Ganghyeok/BLDC_Motor_Controller_24V/Document/참고 문서/pantarhei BLDC 회로도.png

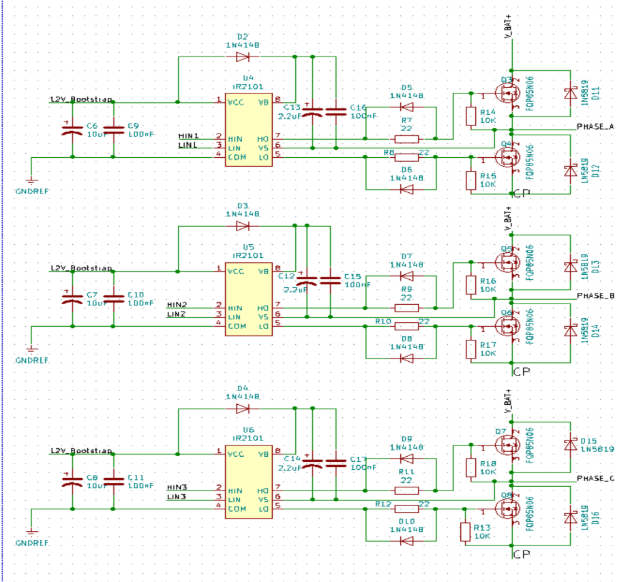
Document/참고 문서/pantarhei BLDC 회로도.png
