Ganghyeok/BLDC_Motor_Controller_24V/Sch/BLDC_Motor_Controller_Ver1.0A(기본 버전).pdf

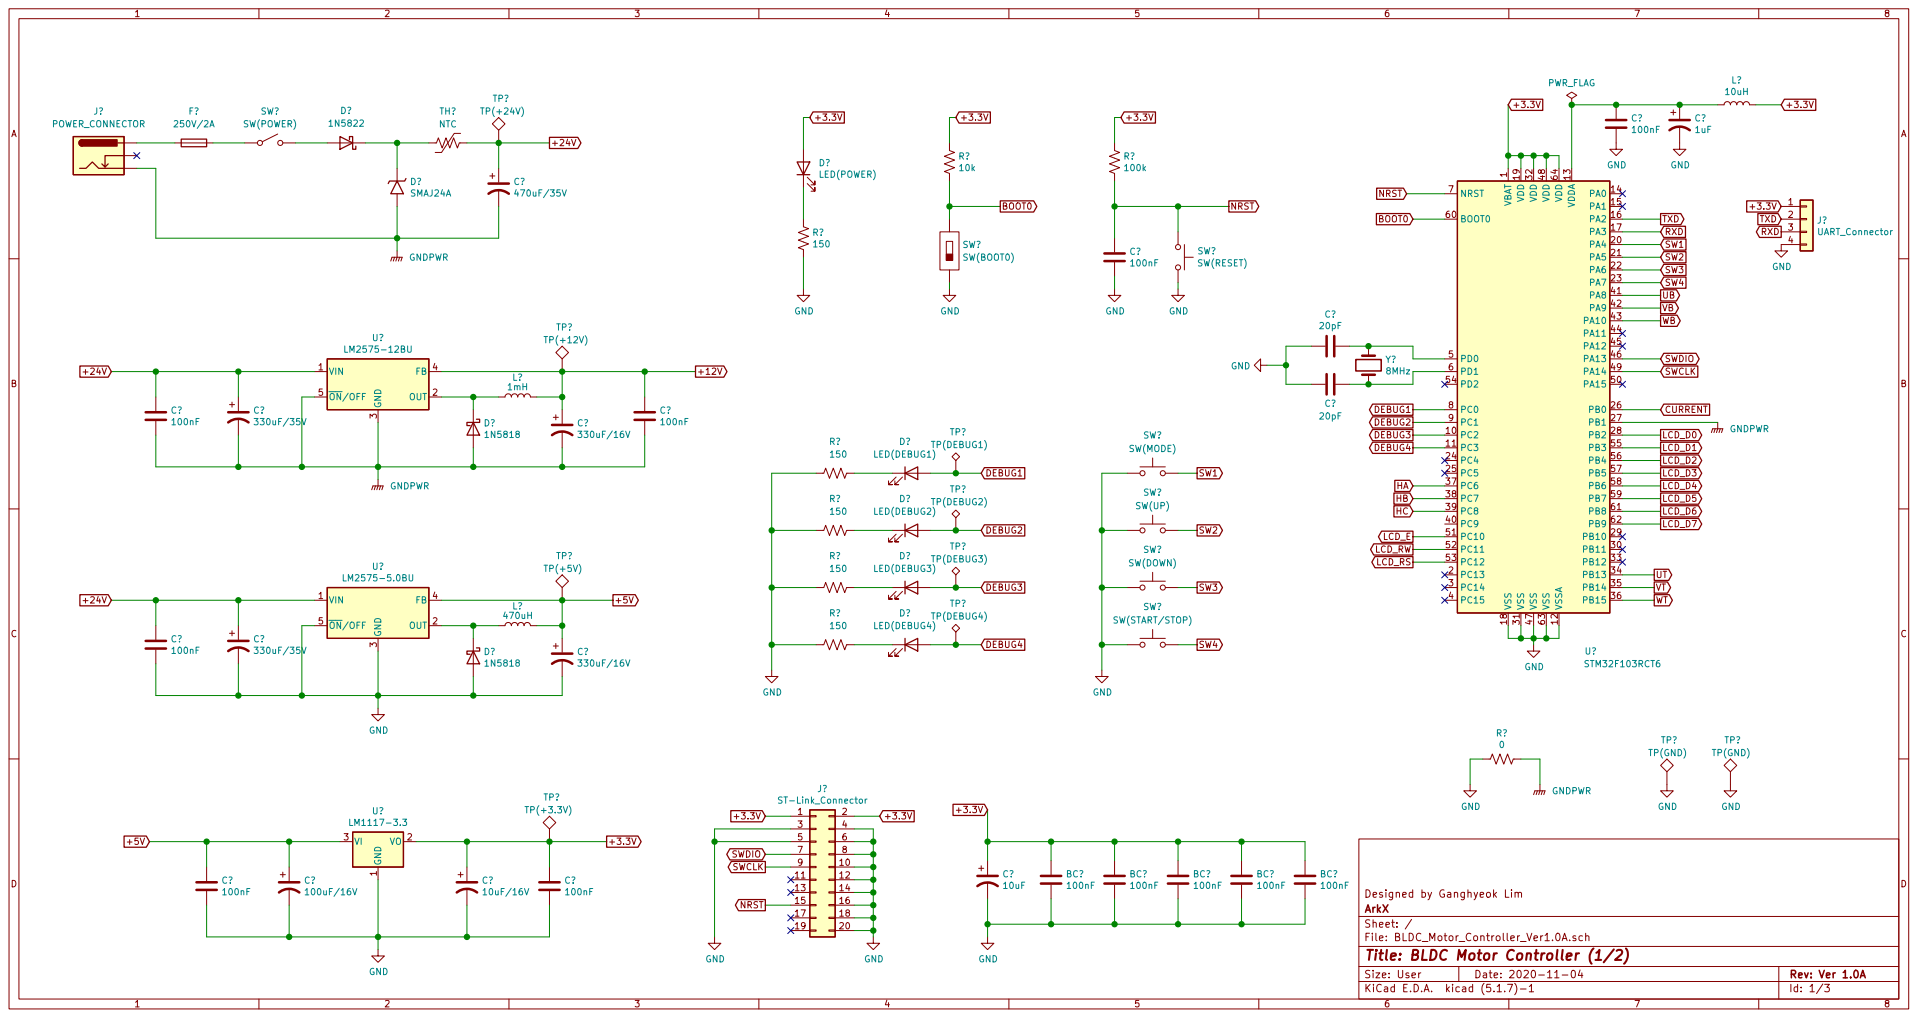
[picture p3: page 1]

TP? TP(DEBUG1) TH? NTC

1 VDD 19 VDD 32 VDD 48 VDD 64 VDDA 13 VSS 18 VSS 31 VSS 47 VSS 63 VSSA 12 U?STM32F103RCT6

SW? SW(START/STOP) GNDPWR

SW? SW(UP) SW? SW(MODE) C?

TP? TP(GND) TP? TP(GND) GNDPWR GND
SW? SW(DOWN) TP? TP(DEBUG2) GND

100nF BC? | File: BLDC_Motor_Controller_Ver1.0A.sch Sheet: / ArkX Designed by Ganghyeok Lim

Id: 1/3 Title: BLDC Motor Controller (1/2)

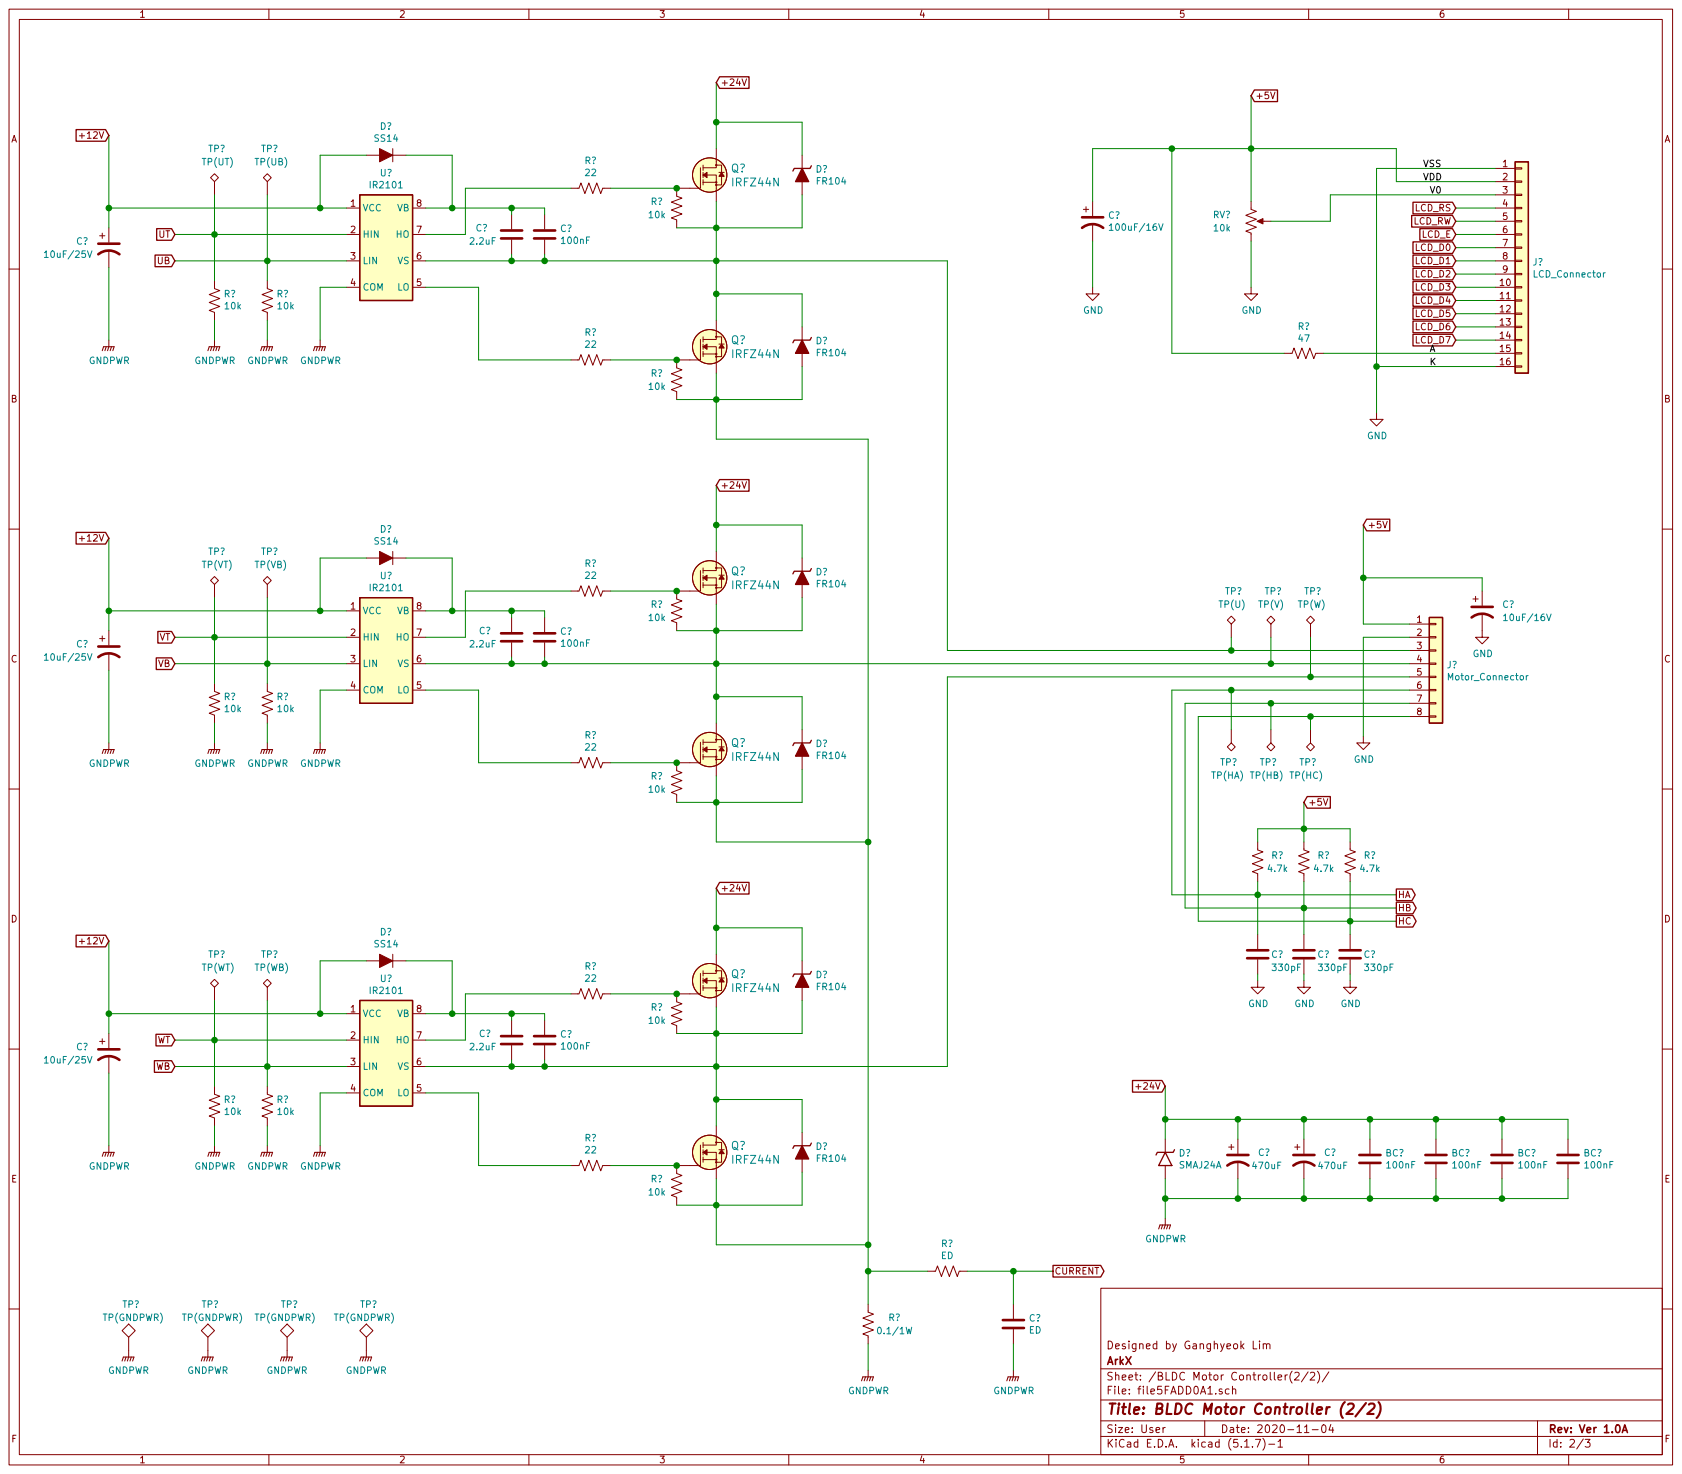
[picture p4: page 2]

Id: 2/3 Title: BLDC Motor Controller (2/2) File: file5FADD0A1.sch Sheet: /BLDC Motor Controller(2/2)/ ArkX Designed by Ganghyeok Lim

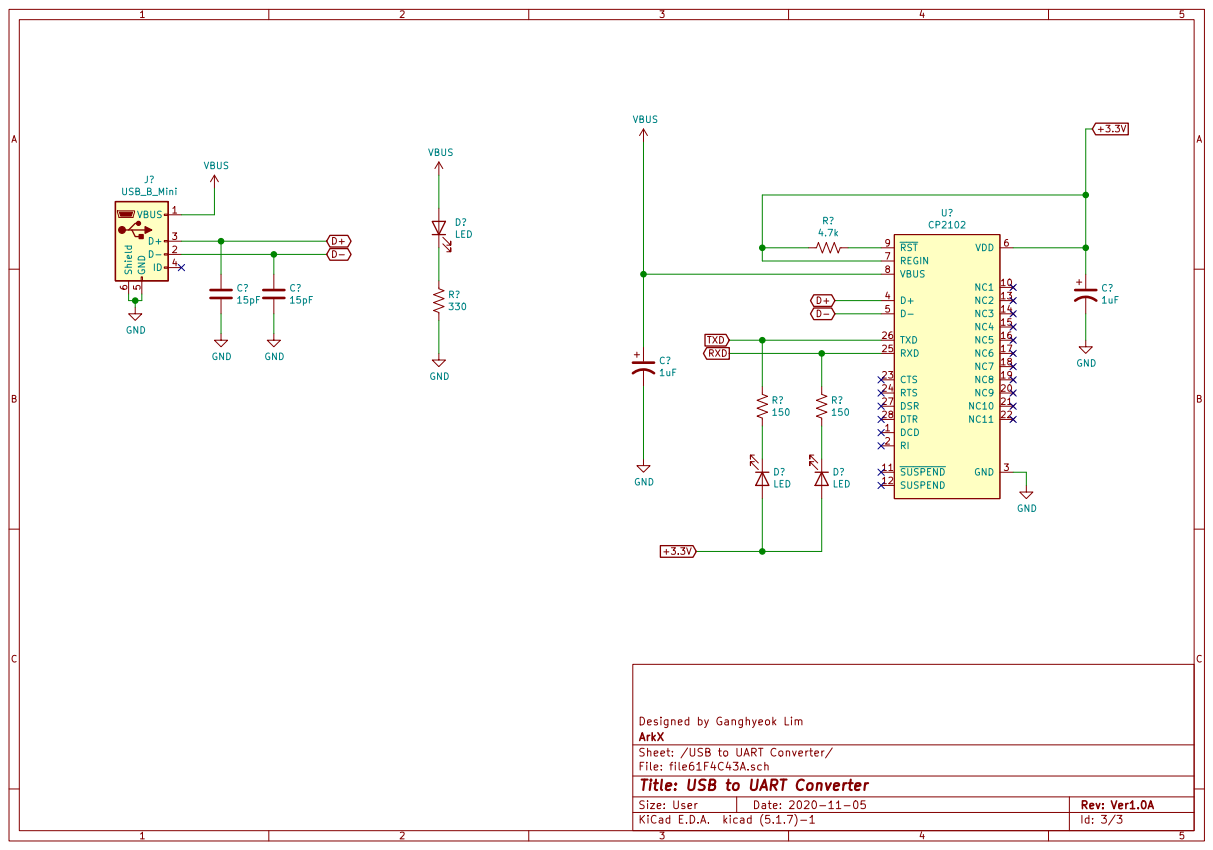
[picture p5: page 3]

Id: 3/3 Title: USB to UART Converter File: file61F4C43A.sch Sheet: /USB to UART Converter/ ArkX Designed by Ganghyeok Lim
