Ganghyeok/BLDC_Motor_Controller_24V/PCB/BLDC_Motor_Controller_Ver2.0A/BLDC_Motor_Controller_Ver2.0A.pdf

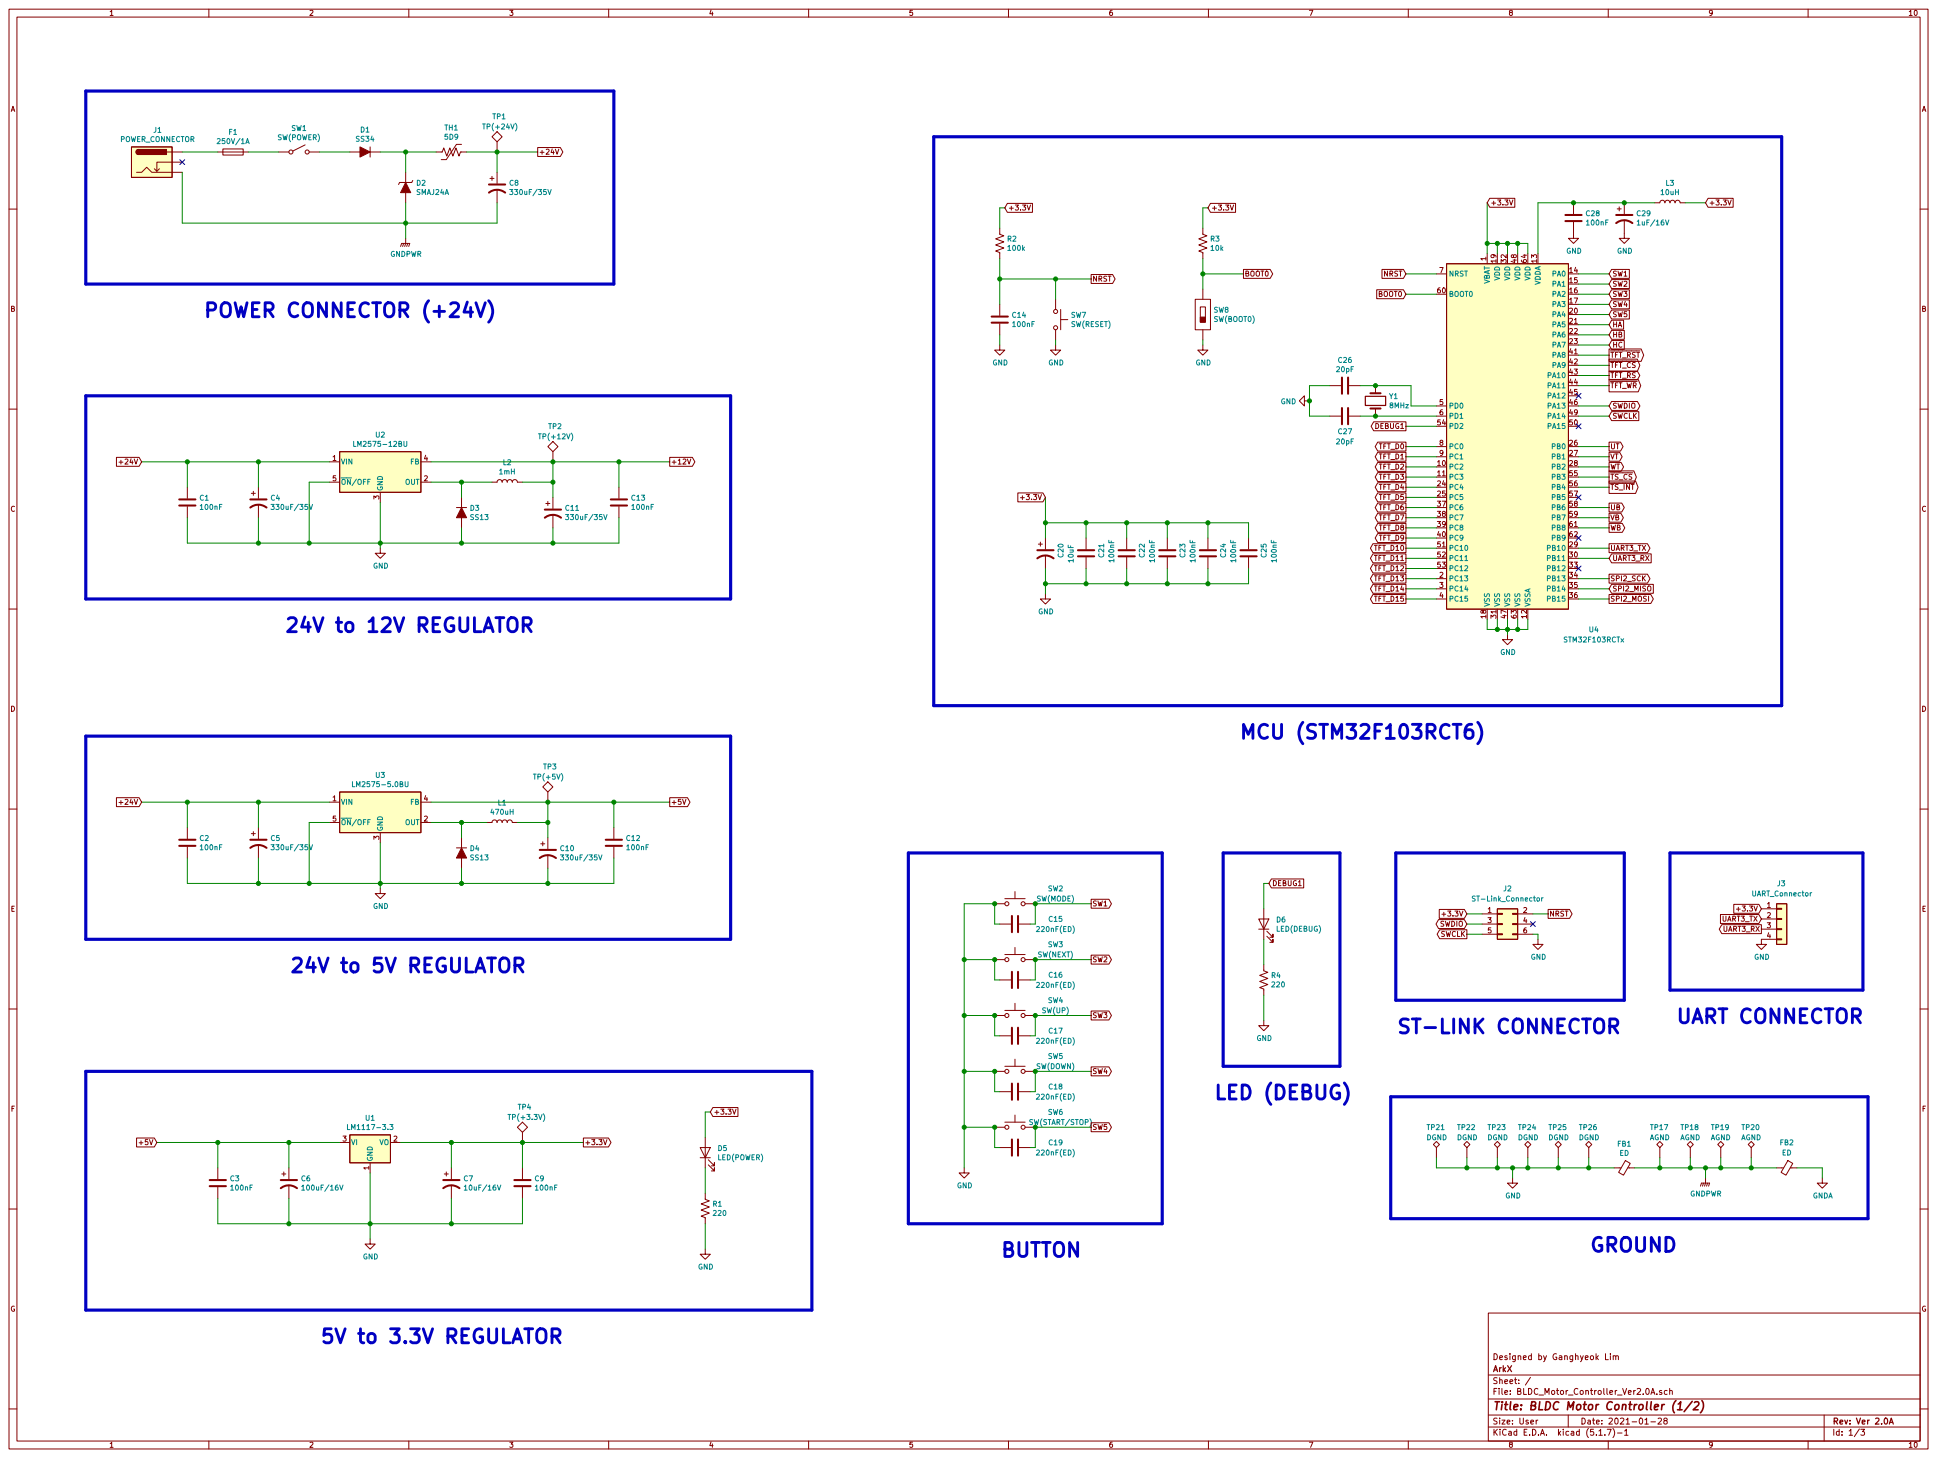
[picture p6: page 1]

1 VDD 19 VDD 32 VDD 48 VDD 64 VDDA 13 VSS 18 VSS 31 VSS 47 VSS 63 VSSA 12 U4 STM32F103RCTx Y1
HBHA NRST

220nF(ED) SW6 SW(START/STOP) C19

File: BLDC_Motor_Controller_Ver2.0A.sch Sheet: / ArkX Designed by Ganghyeok Lim

Id: 1/3 Title: BLDC Motor Controller (1/2)

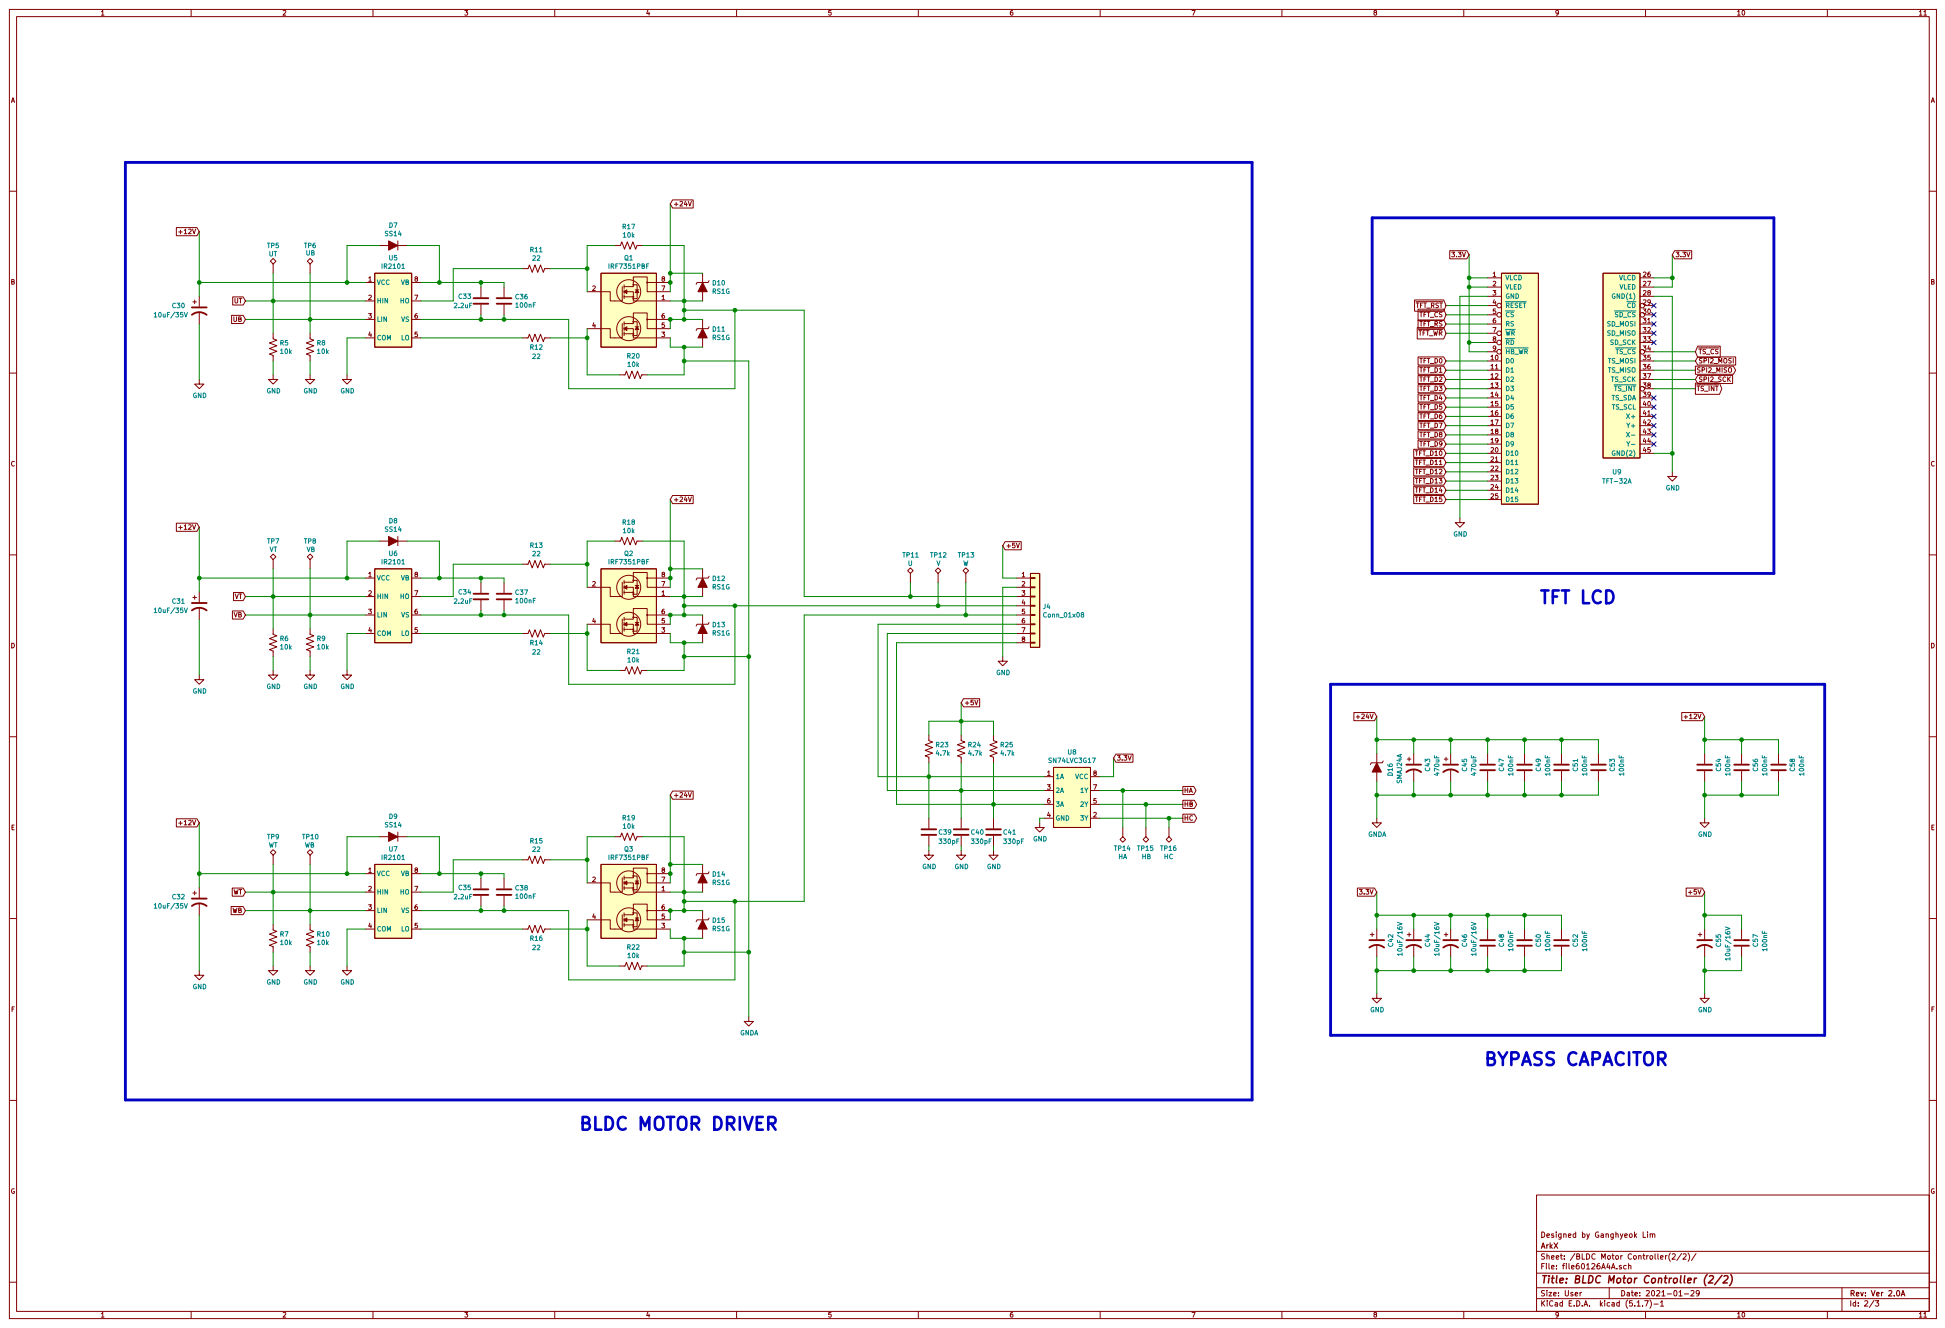
[picture p7: page 2]

Id: 2/3 Title: BLDC Motor Controller (2/2) File: file60126A4A.sch Sheet: /BLDC Motor Controller(2/2)/ ArkX Designed by Ganghyeok Lim

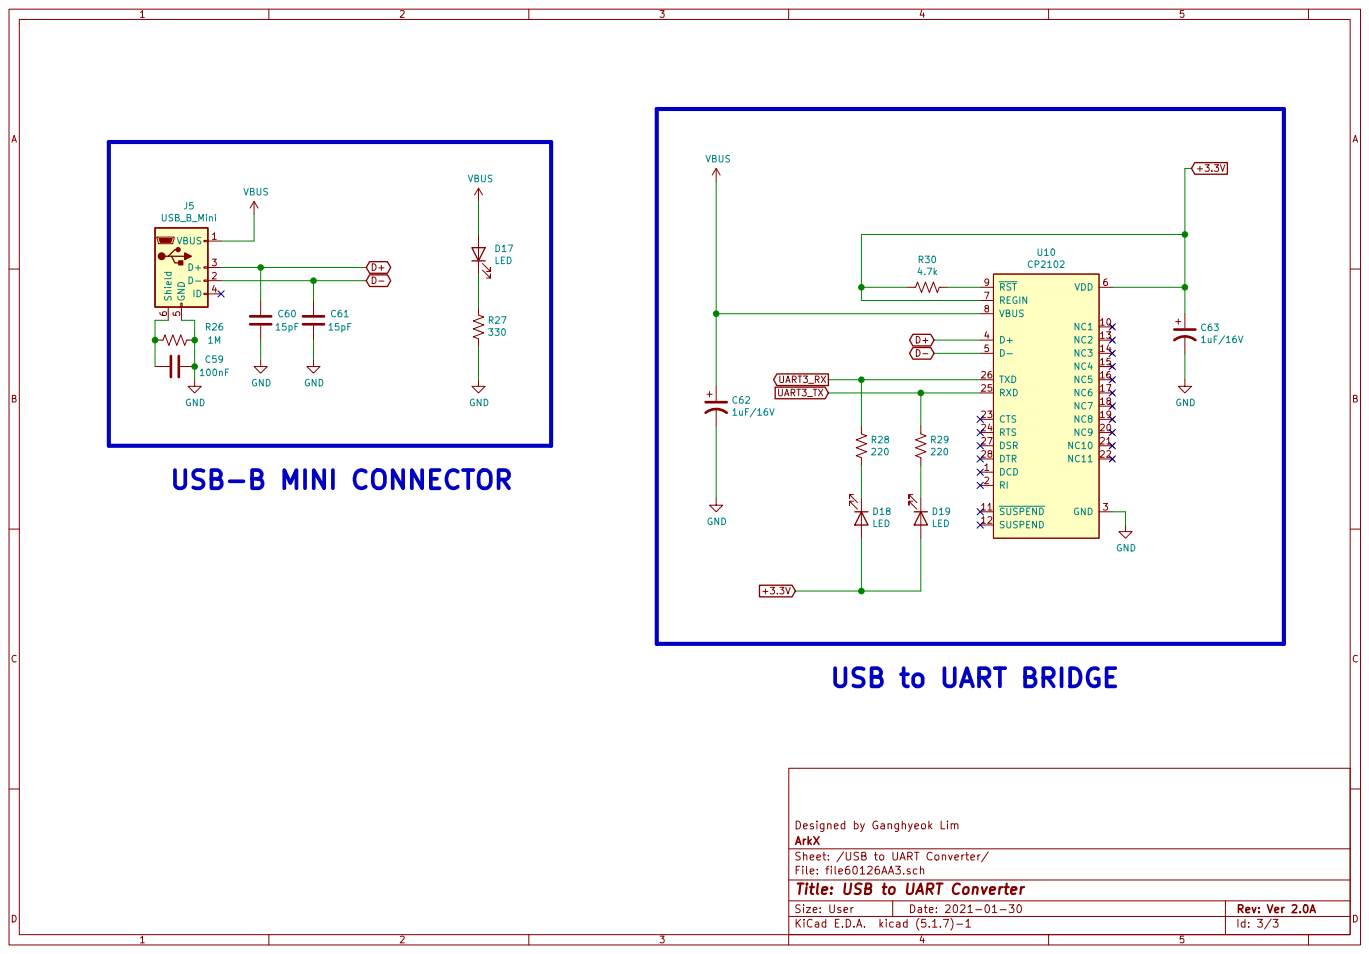
[picture p8: page 3]

Id: 3/3 Title: USB to UART Converter File: file60126AA3.sch Sheet: /USB to UART Converter/ ArkX Designed by Ganghyeok Lim
