Ganghyeok/BLDC_Motor_Controller_24V/Document/참고 문서/STM32F407 커스텀 보드 회로도.pdf

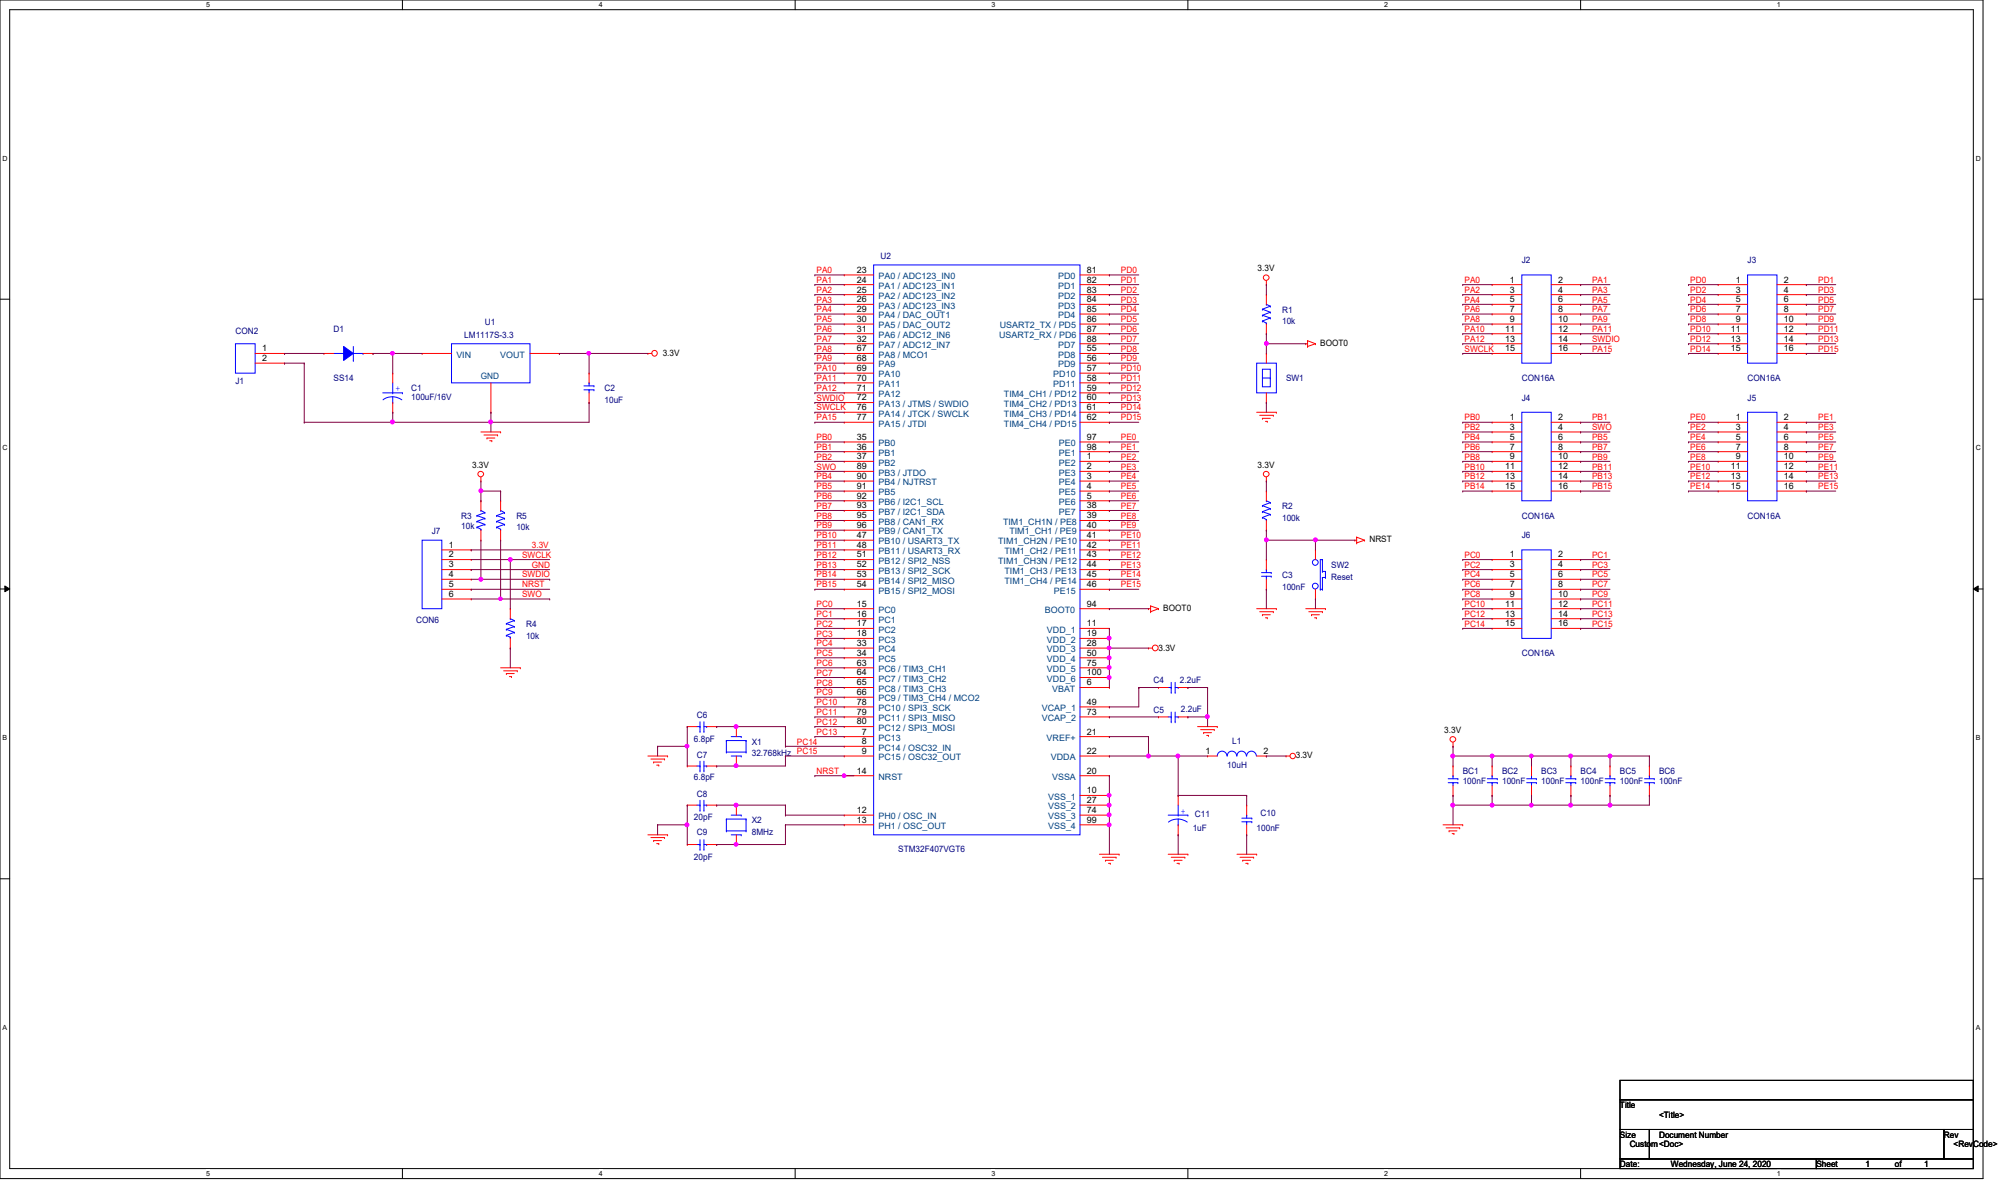
[picture p9: page 1]
