Ganghyeok/BLDC_Motor_Controller_24V/Document/참고 문서/BLDC_Motor_Controller_12V_회로도(Old Ver).pdf

DC
12V

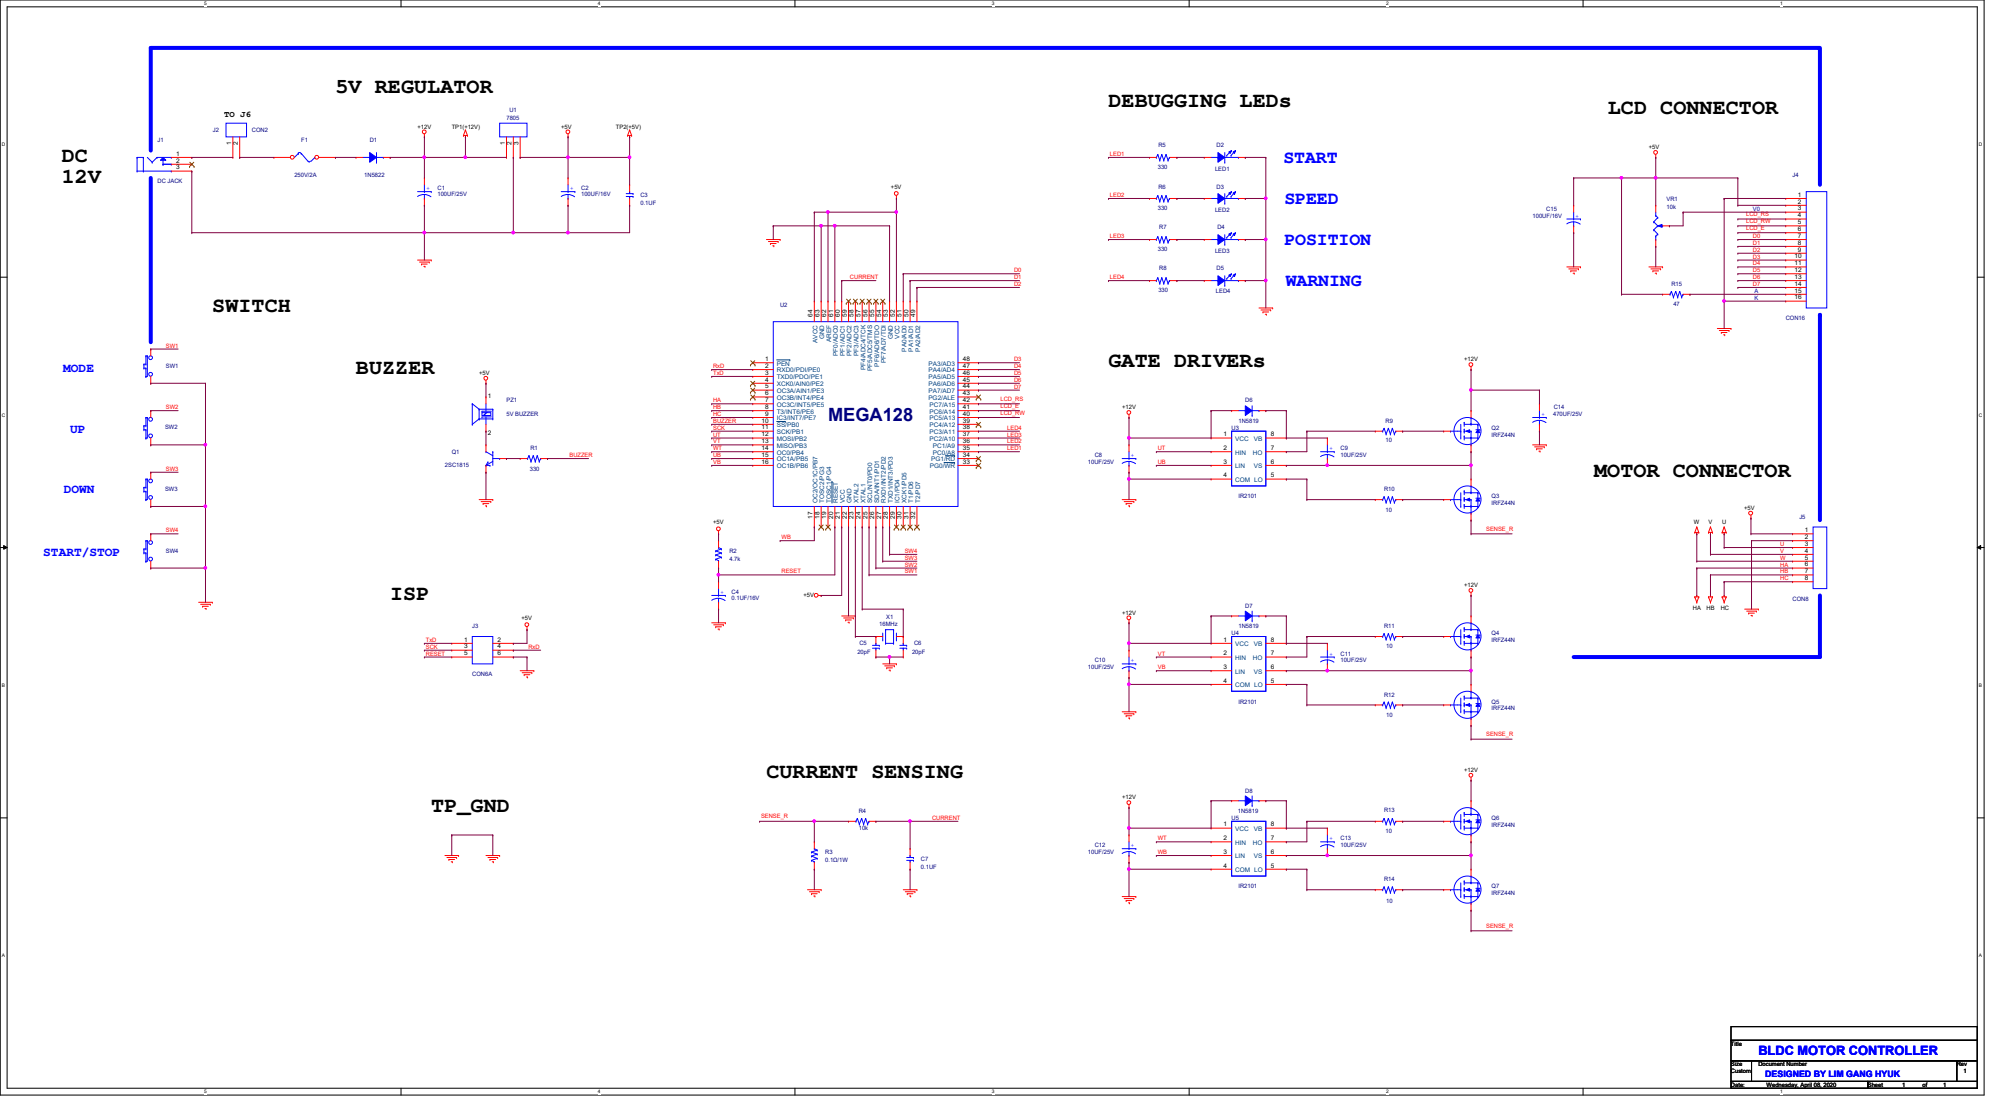
[picture p10: page 1]
