Ganghyeok/BLDC_Motor_Controller_24V/PCB/BLDC_Motor_Controller_Ver2.0A/BLDC_Motor_Controller_Ver2.0A.kicad_pcb

## KiCad design PCB/BLDC_Motor_Controller_Ver2.0A/BLDC_Motor_Controller_Ver2.0A.kicad_pcb (2021-02-27)

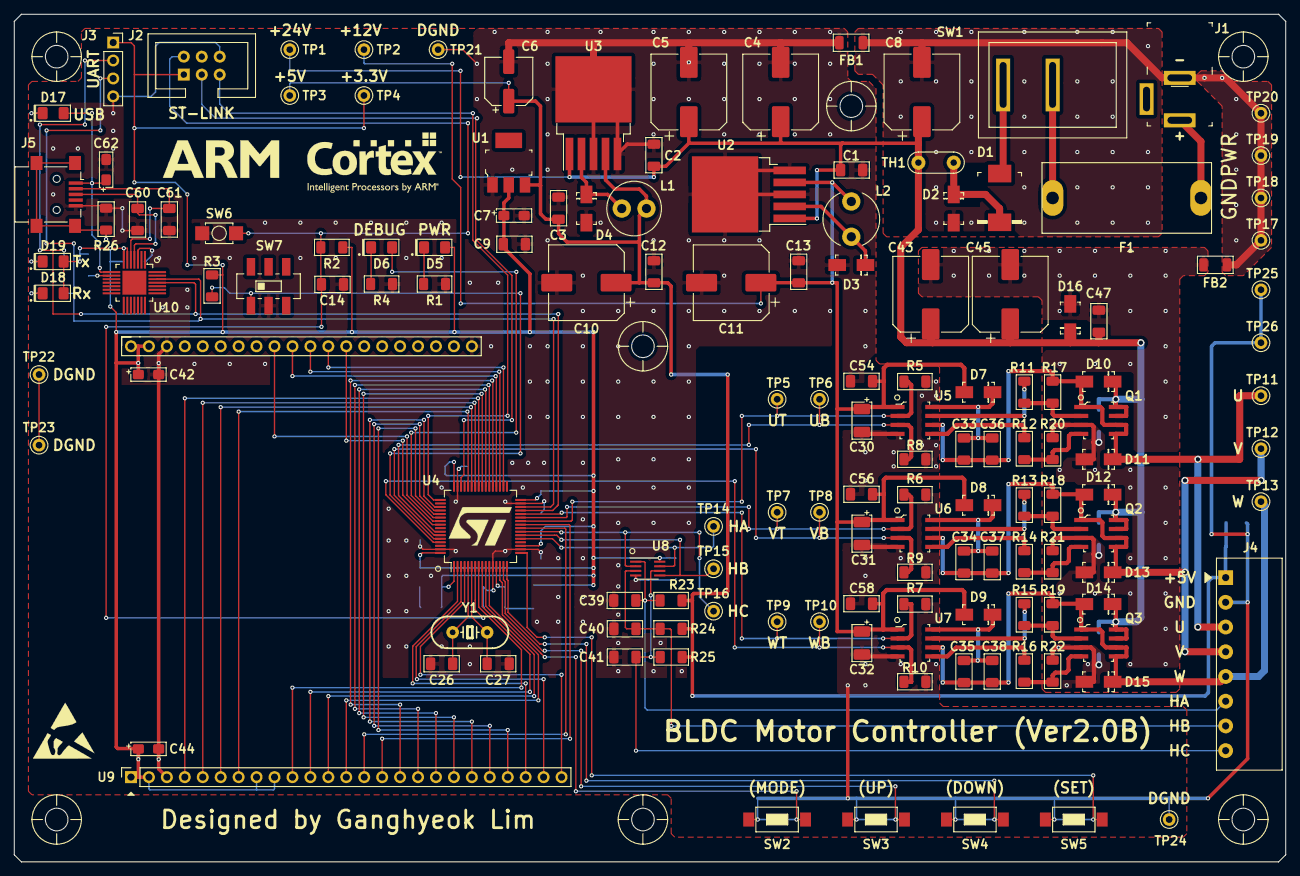
[picture p11: board BLDC_Motor_Controller_Ver2.0A.kicad_pcb from above]

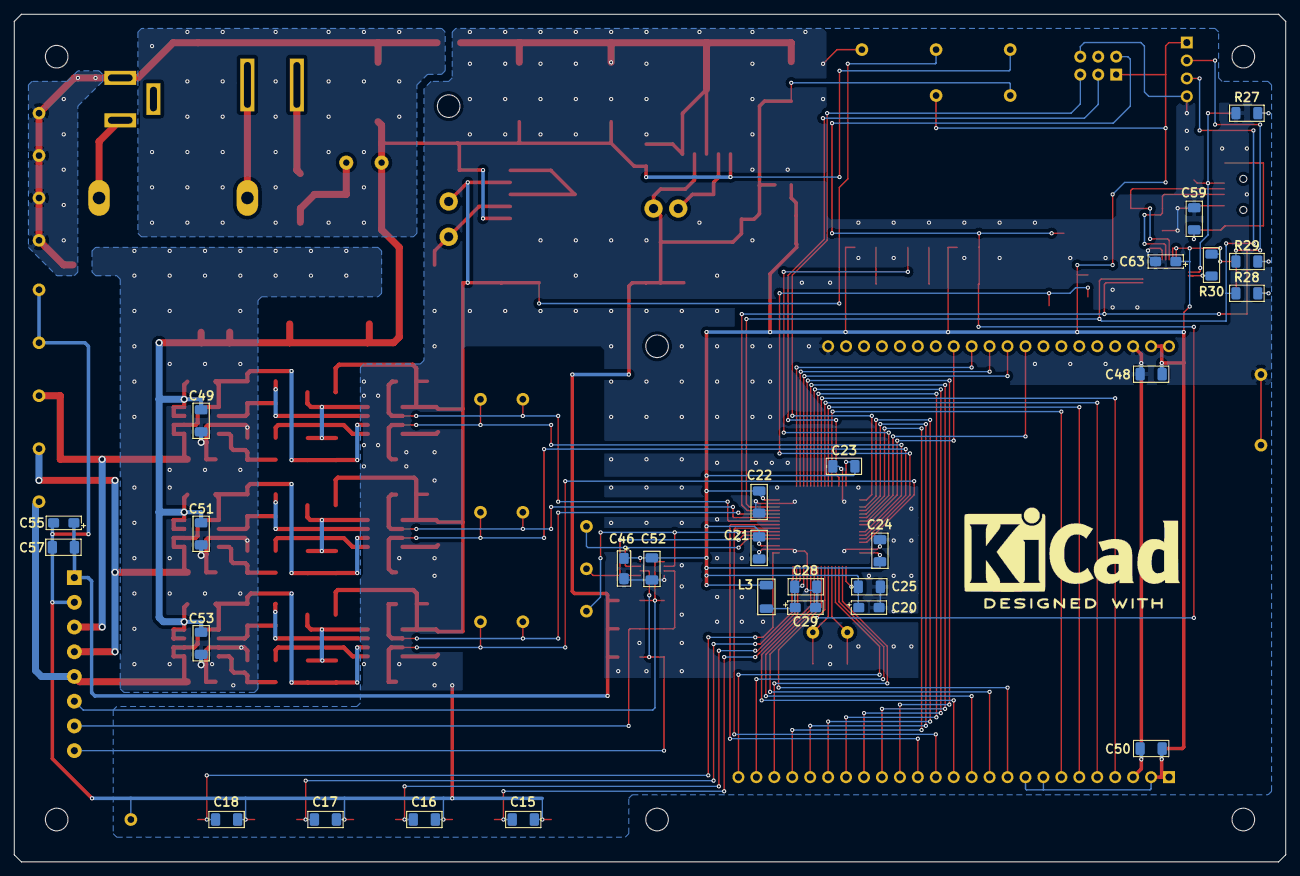
[picture p12: board BLDC_Motor_Controller_Ver2.0A.kicad_pcb from below]

Board: 2 copper layers, 180.0 x 120.0 mm, 170 parts (28 on the bottom side), 92 nets.

Parts:
C1, C2, C3, C9, C12, C13, C14, C21, C22, C23, C24, C25, C28, C36, C37, C38, C47, C48, C49, C50, C51, C52, C53, C54, C56, C57, C58, C59: 100nF; C3216_Metric
C4, C5, C8, C10, C11: 330uF/35V; CP_Elec_10x10.5
C6: 100uF/16V; CP_Elec_6.3x5.3
C7, C20, C42, C44, C46, C55: 10uF/16V; C3216_Tantal_Metric
C15, C16, C17, C18: 220nF(ED); C3216_Metric
C26, C27: 20pF; C3216_Metric
C29, C62, C63: 1uF/16V; C3216_Tantal_Metric
C30, C31, C32: 10uF/25V; C3528_Tantal_Metric
C33, C34, C35: 2.2uF; C3216_Metric
C39, C40, C41: 330pF; C3216_Metric
C43, C45: 470uF/35V; CP_Elec_10x10.5
C60, C61: 15pF; C3216_Metric
D1: SS34; DO-214AB
D2, D16: SMAJ24A; DO-214AC
D3, D4: SS13; DO-214AC
D5: LED(POWER); LED_3216_Metric
D6: LED(DEBUG); LED_3216_Metric
D7, D8, D9: SS14; DO-214AC
D10, D11, D12, D13, D14, D15: RS1G; DO-214AC
D17, D18, D19: LED; LED_3216_Metric
F1: 250V/1A; GF-205B(20mm)
FB1, FB2: ED; L3216_Metric
J1: POWER_CONNECTOR; Barrel_Jack_5.5mmODx2.1mmID_PJ-202A
J2: ST-Link_Connector; BHS-01-6P
J3: UART_Connector; PinSocket_1x04_P2.54mm_Vertical
J4: Conn_01x08; Terminal_Block_3.5mm_8P
J5: USB_B_Mini; USB_Mini-B_Lumberg_2486_01_Horizontal
L1: 470uH; L_Radial_D7.5mm_P3.50mm_Fastron_07P
L2: 1mH; L_Radial_D7.8mm_P5.00mm_Fastron_07HCP
L3: 10uH; L3216_Metric
Q1, Q2, Q3: IRF7351PBF; SOIC-8_W3.9mm
R1, R4, R28, R29: 220; R3216_Metric
R2: 100k; R3216_Metric
R3, R5, R6, R7, R8, R9, R10, R17, R18, R19, R20, R21, R22: 10k; R3216_Metric
R11, R12, R13, R14, R15, R16: 22; R3216_Metric
R23, R24, R25, R30: 4.7k; R3216_Metric
R26: 1M; R3216_Metric
R27: 330; R3216_Metric
SW1: SW(POWER); KCD1-101A
SW2: SW(MODE); ITS-1107(SMD)
SW3: SW(UP); ITS-1107(SMD)
SW4: SW(DOWN); ITS-1107(SMD)
SW5: SW(START/STOP); ITS-1107(SMD)
SW6: SW(RESET); SW_TACT_SMD_W3.9mm_L2.9mm_H2mm_GH
SW7: SW(BOOT0); SW_Slide_6P_SMD_GH
TH1: 5D9; NTC-5D-7_9
TP1: TP(+24V); Test_Point(Loop)
TP2: TP(+12V); Test_Point(Loop)
TP3: TP(+5V); Test_Point(Loop)
TP4: TP(+3.3V); Test_Point(Loop)
TP5: UT; Test_Point(Loop)
TP6: UB; Test_Point(Loop)
TP7: VT; Test_Point(Loop)
TP8: VB; Test_Point(Loop)
TP9: WT; Test_Point(Loop)
TP10: WB; Test_Point(Loop)
TP11: U; Test_Point(Loop)
TP12: V; Test_Point(Loop)
TP13: W; Test_Point(Loop)
TP14: HA; Test_Point(Loop)
TP15: HB; Test_Point(Loop)
TP16: HC; Test_Point(Loop)
TP17, TP18, TP19, TP20: AGND; Test_Point(Loop)
TP21, TP22, TP23, TP24, TP25, TP26: DGND; Test_Point(Loop)
U1: LM1117-3.3; SOT-223
U2: LM2575-12BU; TO-263-5_TabPin3
U3: LM2575-5.0BU; TO-263-5_TabPin3
U4: STM32F103RCTx; LQFP-64_10x10mm_P0.5mm
U5, U6, U7: IR2101; SOIC-8_W3.9mm
U8: SN74LVC3G17; SSOP-8_2.95x2.8mm_P0.65mm
U9: TFT-32A
U10: CP2102; VFQFN-28-1EP_5x5mm_HandSolder
Y1: 8MHz; CRYSTAL_HC49_PTH

Connections:
+3.3V: C7.1, C9.1, C20.1, C21.1, C22.1, C23.1, C24.1, C25.1, C42.1, C44.1, C46.1, C48.1, C50.1, C52.1, C63.1, D5.2, D18.2, D19.2, J2.1, J3.1, L3.2, R2.1, R3.1, R30.1, TP4.1, U1.2, U4.1, U4.19, U4.32, U4.48, U4.64, U8.8, U9.1, U9.2, U9.8, U9.9, U9.26, U9.27, U10.6, U10.7
+5V: C3.1, C6.1, C10.1, C12.1, C55.1, C57.1, J4.1, L1.2, R23.1, R24.1, R25.1, TP3.1, U1.3, U3.4
+12V: C11.1, C13.1, C30.1, C31.1, C32.1, C54.1, C56.1, C58.1, D7.A, D8.A, D9.A, L2.2, TP2.1, U2.4, U5.1, U6.1, U7.1
+24V: C1.1, C2.1, C4.1, C5.1, C8.1, C43.1, C45.1, C47.1, C49.1, C51.1, C53.1, D10.K, D12.K, D14.K, D16.K, Q1.7, Q1.8, Q2.7, Q2.8, Q3.7, Q3.8, TH1.1, TP1.1, U2.1, U3.1
BOOT0: R3.2, SW7.1, U4.60
D+: C60.1, J5.3, U10.4
D-: C61.1, J5.2, U10.5
DEBUG1: D6.2, U4.54
GND: C1.2, C2.2, C3.2, C4.2, C5.2, C6.2, C7.2, C9.2, C10.2, C11.2, C12.2, C13.2, C14.2, C15.2, C16.2, C17.2, C18.2, C20.2, C21.2, C22.2, C23.2, C24.2, C25.2, C26.2, C27.2, C28.2, C29.2, C30.2, C31.2, C32.2, C39.2, C40.2, C41.2, C42.2, C44.2, C46.2, C48.2, C50.2, C52.2, C54.2, C55.2, C56.2, C57.2, C58.2, C59.2, C60.2, C61.2, C62.2, C63.2, D3.A, D4.A, FB1.2, J2.6, J3.4, J4.2, J5.5, R1.2, R4.2, R5.2, R6.2, R7.2, R8.2, R9.2, R10.2, R26.1, R27.1, SW2.1, SW3.1, SW4.1, SW5.1, SW6.2, SW7.2, TP21.1, TP22.1, TP23.1, TP24.1, TP25.1, TP26.1, U1.1, U2.3, U2.5, U3.3, U3.5, U4.12, U4.18, U4.31, U4.47, U4.63, U5.4, U6.4, U7.4, U8.4, U9.3, U9.28, U9.45, U10.3
GNDA: C43.2, C45.2, C47.2, C49.2, C51.2, C53.2, D11.A, D13.A, D15.A, D16.A, FB2.1, Q1.3, Q2.3, Q3.3, R20.1, R21.1, R22.1
GNDPWR: C8.2, D2.A, FB1.1, FB2.2, J1.2, TP17.1, TP18.1, TP19.1, TP20.1
HA: TP14.1, U4.21, U8.7
HB: TP15.1, U4.22, U8.5
HC: TP16.1, U4.23, U8.2
NRST: C14.1, J2.2, R2.2, SW6.1, U4.7
unnamed: C26.1, U4.5, Y1.1
unnamed: C27.1, U4.6, Y1.2
unnamed: C28.1, C29.1, L3.1, U4.13
unnamed: C33.1, C36.1, D7.K, U5.8
unnamed: C33.2, C36.2, D10.A, D11.K, J4.3, Q1.1, Q1.5, Q1.6, R17.1, TP11.1, U5.6
unnamed: C34.1, C37.1, D8.K, U6.8
unnamed: C34.2, C37.2, D12.A, D13.K, J4.4, Q2.1, Q2.5, Q2.6, R18.1, TP12.1, U6.6
unnamed: C35.1, C38.1, D9.K, U7.8
unnamed: C35.2, C38.2, D14.A, D15.K, J4.5, Q3.1, Q3.5, Q3.6, R19.1, TP13.1, U7.6
unnamed: C39.1, J4.6, R23.2, U8.1
unnamed: C40.1, J4.7, R24.2, U8.3
unnamed: C41.1, J4.8, R25.2, U8.6
unnamed: C59.1, J5.6, R26.2
unnamed: D1.A, SW1.2
unnamed: D1.K, D2.K, TH1.2
unnamed: D3.K, L2.1, U2.2
unnamed: D4.K, L1.1, U3.2
unnamed: D5.1, R1.1
unnamed: D6.1, R4.1
unnamed: D17.1, R27.2
unnamed: D18.1, R28.2
unnamed: D19.1, R29.2
unnamed: F1.1, SW1.1
unnamed: F1.2, J1.1
unnamed: Q1.2, R11.1, R17.2
unnamed: Q1.4, R12.1, R20.2
unnamed: Q2.2, R13.1, R18.2
unnamed: Q2.4, R14.1, R21.2
unnamed: Q3.2, R15.1, R19.2
unnamed: Q3.4, R16.1, R22.2
unnamed: R11.2, U5.7
unnamed: R12.2, U5.5
unnamed: R13.2, U6.7
unnamed: R14.2, U6.5
unnamed: R15.2, U7.7
unnamed: R16.2, U7.5
unnamed: R30.2, U10.9
SPI2_MISO: U4.35, U9.36
SPI2_MOSI: U4.36, U9.35
SPI2_SCK: U4.34, U9.37
SW1: C15.1, SW2.2, U4.14
SW2: C16.1, SW3.2, U4.15
SW3: C17.1, SW4.2, U4.16
SW4: C18.1, SW5.2, U4.17
SWCLK: J2.5, U4.49
SWDIO: J2.3, U4.46
TFT_D0: U4.8, U9.10
TFT_D1: U4.9, U9.11
TFT_D2: U4.10, U9.12
TFT_D3: U4.11, U9.13
TFT_D4: U4.24, U9.14
TFT_D5: U4.25, U9.15
TFT_D6: U4.37, U9.16
TFT_D7: U4.38, U9.17
TFT_D8: U4.39, U9.18
TFT_D9: U4.40, U9.19
TFT_D10: U4.51, U9.20
TFT_D11: U4.52, U9.21
TFT_D12: U4.53, U9.22
TFT_D13: U4.2, U9.23
TFT_D14: U4.3, U9.24
TFT_D15: U4.4, U9.25
TFT_RS: U4.43, U9.6
UART3_RX: J3.3, R28.1, U4.30, U10.26
UART3_TX: J3.2, R29.1, U4.29, U10.25
UB: R8.1, TP6.1, U4.58, U5.3
UT: R5.1, TP5.1, U4.26, U5.2
VB: R9.1, TP8.1, U4.59, U6.3
VBUS: C62.1, D17.2, J5.1, U10.8
VT: R6.1, TP7.1, U4.27, U6.2
WB: R10.1, TP10.1, U4.61, U7.3
WT: R7.1, TP9.1, U4.28, U7.2
~TFT_CS: U4.42, U9.5
~TFT_RST: U4.41, U9.4
~TFT_WR: U4.44, U9.7
~TS_CS: U4.55, U9.34
~TS_INT: U4.56, U9.38
