Ganghyeok/BLDC_Motor_Controller_24V/PCB/BLDC_Motor_Controller_Ver1.0A_TEST/BLDC_Motor_Controller_Ver1.0A_TEST.kicad_pcb

## KiCad design PCB/BLDC_Motor_Controller_Ver1.0A_TEST/BLDC_Motor_Controller_Ver1.0A_TEST.kicad_pcb (2021-02-27)

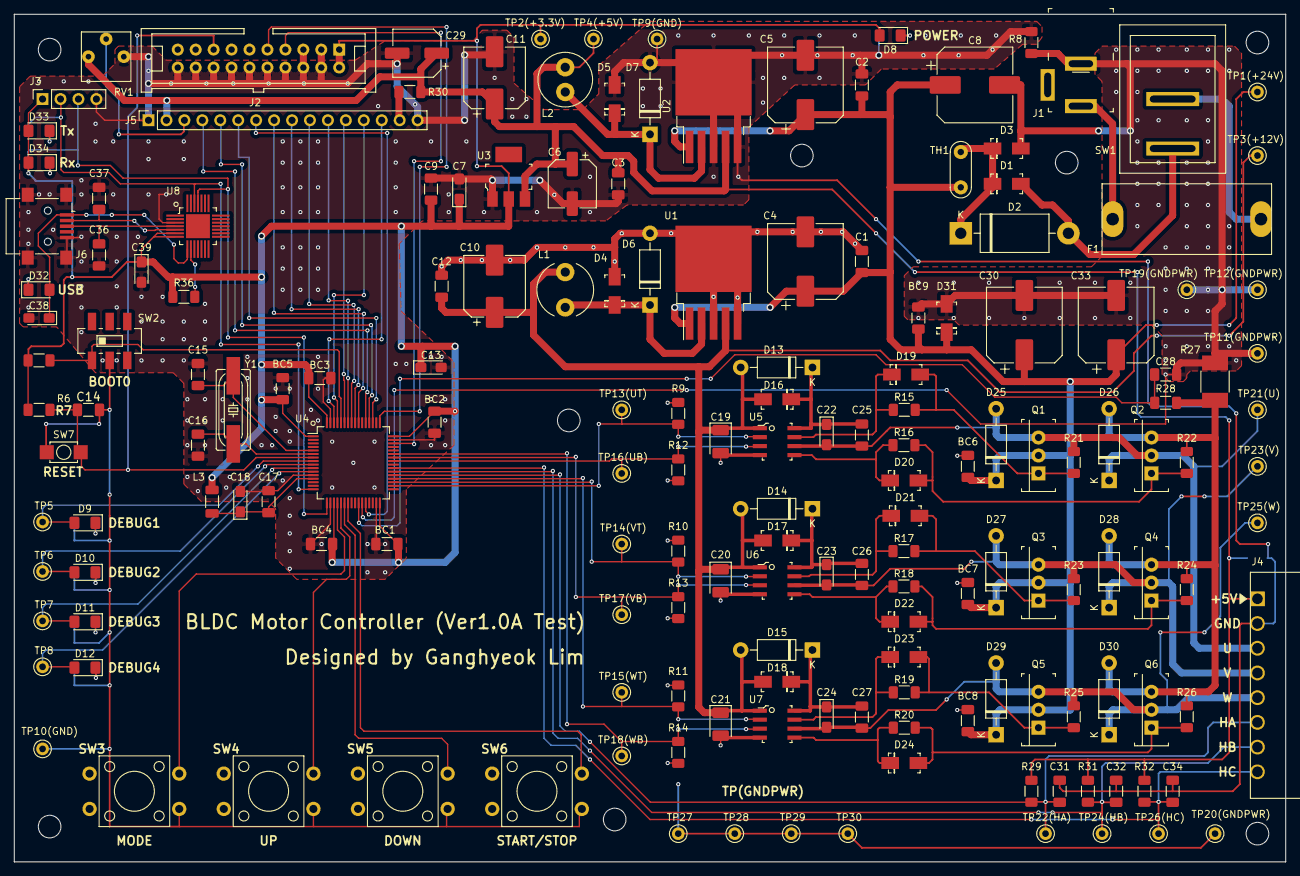
[picture p13: board BLDC_Motor_Controller_Ver1.0A_TEST.kicad_pcb from above]

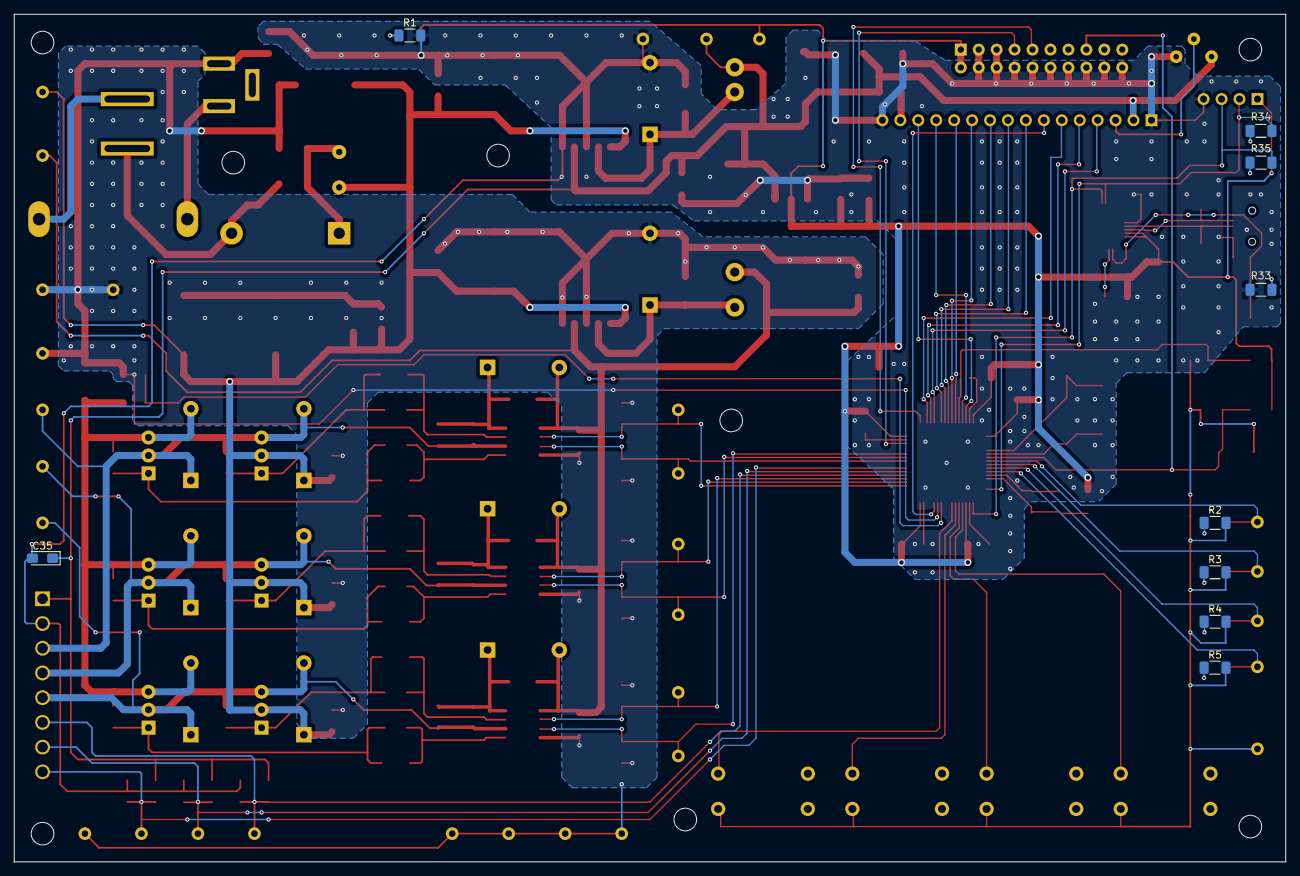
[picture p14: board BLDC_Motor_Controller_Ver1.0A_TEST.kicad_pcb from below]

Board: 2 copper layers, 180.0 x 120.0 mm, 182 parts (9 on the bottom side), 83 nets.

Parts:
BC1, BC2, BC3, BC4, BC5, BC6, BC7, BC8, BC9: 100nF; C_1206_3216Metric_Pad1.33x1.80mm_HandSolder
C1, C2, C3, C9, C12, C14, C17, C25, C26, C27: 100nF; C_1206_3216Metric_Pad1.33x1.80mm_HandSolder
C4, C5: 330uF/35V; CP_Elec_10x10.5
C6, C29: 100uF/16V; CP_Elec_6.3x5.3
C7, C35: 10uF/16V; CP_EIA-3216-18_Kemet-A_Pad1.58x1.35mm_HandSolder
C8: 470uF/35V; CP_Elec_10x10.5
C10, C11: 330uF/16V; CP_Elec_8x10.5
C13: 10uF; CP_EIA-3216-18_Kemet-A_Pad1.58x1.35mm_HandSolder
C15, C16: 20pF; C_1206_3216Metric_Pad1.33x1.80mm_HandSolder
C18, C38, C39: 1uF; CP_EIA-3216-18_Kemet-A_Pad1.58x1.35mm_HandSolder
C19, C20, C21: 10uF/25V; CP_EIA-3528-21_Kemet-B_Pad1.50x2.35mm_HandSolder
C22, C23, C24: 2.2uF; CP_EIA-3216-18_Kemet-A_Pad1.58x1.35mm_HandSolder
C28: ED; C_1206_3216Metric_Pad1.33x1.80mm_HandSolder
C30, C33: 470uF; CP_Elec_10x10.5
C31, C32, C34: 330pF; C_1206_3216Metric_Pad1.33x1.80mm_HandSolder
C36, C37: 15pF; C_1206_3216Metric_Pad1.33x1.80mm_HandSolder
D1: SS24; DO-214AC
D2: 1N5822; D_DO-201AD_P15.24mm_Horizontal
D3, D31: SMAJ24A; DO-214AC
D4, D5: SS13(NC); DO-214AC
D6, D7: 1N5818; D_DO-41_SOD81_P10.16mm_Horizontal
D8: LED(POWER); LED_1206_3216Metric_Pad1.42x1.75mm_HandSolder
D9: LED(DEBUG1); LED_1206_3216Metric_Pad1.42x1.75mm_HandSolder
D10: LED(DEBUG2); LED_1206_3216Metric_Pad1.42x1.75mm_HandSolder
D11: LED(DEBUG3); LED_1206_3216Metric_Pad1.42x1.75mm_HandSolder
D12: LED(DEBUG4); LED_1206_3216Metric_Pad1.42x1.75mm_HandSolder
D13, D14, D15: 1N5819(NC); D_DO-41_SOD81_P10.16mm_Horizontal
D16, D17, D18, D19, D20, D21, D22, D23, D24: SS14; DO-214AC
D25, D26, D27, D28, D29, D30: FR104; D_DO-41_SOD81_P10.16mm_Horizontal
D32, D33, D34: LED; LED_1206_3216Metric_Pad1.42x1.75mm_HandSolder
F1: 250V/2A; GF-205B(20mm)
J1: POWER_CONNECTOR; Barrel_Jack_5.5mmODx2.1mmID_PJ-202A
J2: ST-Link_Connector; HIF3F-20PA-2.54DSA_GH
J3: UART_Connector; PinSocket_1x04_P2.54mm_Vertical
J4: Motor_Connector; ECH350R(8P)
J5: LCD_Connector; PinSocket_1x16_P2.54mm_Vertical
J6: USB_B_Mini; USB_Mini-B_Lumberg_2486_01_Horizontal
L1: 1mH; L_Radial_D7.8mm_P5.00mm_Fastron_07HCP
L2: 470uH; L_Radial_D7.5mm_P3.50mm_Fastron_07P
L3: 10uH; L_1206_3216Metric_Pad1.22x1.90mm_HandSolder
Q1, Q2, Q3, Q4, Q5, Q6: IRFZ44N; TO-220-3
R1, R2, R3, R4, R5, R34, R35: 150; R_1206_3216Metric_Pad1.30x1.75mm_HandSolder
R6, R9, R10, R11, R12, R13, R14, R21, R22, R23, R24, R25, R26: 10k; R_1206_3216Metric_Pad1.30x1.75mm_HandSolder
R7: 100k; R_1206_3216Metric_Pad1.30x1.75mm_HandSolder
R8: 0; R_1206_3216Metric_Pad1.30x1.75mm_HandSolder
R15, R16, R17, R18, R19, R20: 22; R_1206_3216Metric_Pad1.30x1.75mm_HandSolder
R27: 0.1/1W; LR2512-21R100F4
R28: ED; R_1206_3216Metric_Pad1.30x1.75mm_HandSolder
R29, R31, R32, R36: 4.7k; R_1206_3216Metric_Pad1.30x1.75mm_HandSolder
R30: 47; R_1206_3216Metric_Pad1.30x1.75mm_HandSolder
R33: 330; R_1206_3216Metric_Pad1.30x1.75mm_HandSolder
RV1: 10k; Tocos_GF063P
SW1: SW(POWER); KCD1-101A
SW2: SW(BOOT0); SW_Slide_6P_SMD_GH
SW3: SW(MODE); ITS-1103W
SW4: SW(UP); ITS-1103W
SW5: SW(DOWN); ITS-1103W
SW6: SW(START/STOP); ITS-1103W
SW7: SW(RESET); SW_TACT_SMD_W3.9mm_L2.9mm_H2mm_GH
TH1: NTC; NTC-5D-7_9
TP1(+24V): TP(+24V); Test_Point(Loop)
TP2(+3.3V): TP(+3.3V); Test_Point(Loop)
TP3(+12V): TP(+12V); Test_Point(Loop)
TP4(+5V): TP(+5V); Test_Point(Loop)
TP5: TP(DEBUG1); Test_Point(Loop)
TP6: TP(DEBUG2); Test_Point(Loop)
TP7: TP(DEBUG3); Test_Point(Loop)
TP8: TP(DEBUG4); Test_Point(Loop)
TP9(GND), TP10(GND): TP(GND); Test_Point(Loop)
TP11(GNDPWR), TP12(GNDPWR), TP19(GNDPWR), TP20(GNDPWR), TP27, TP28, TP29, TP30: TP(GNDPWR); Test_Point(Loop)
TP13(UT): TP(UT); Test_Point(Loop)
TP14(VT): TP(VT); Test_Point(Loop)
TP15(WT): TP(WT); Test_Point(Loop)
TP16(UB): TP(UB); Test_Point(Loop)
TP17(VB): TP(VB); Test_Point(Loop)
TP18(WB): TP(WB); Test_Point(Loop)
TP21(U): TP(U); Test_Point(Loop)
TP22(HA): TP(HA); Test_Point(Loop)
TP23(V): TP(V); Test_Point(Loop)
TP24(HB): TP(HB); Test_Point(Loop)
TP25(W): TP(W); Test_Point(Loop)
TP26(HC): TP(HC); Test_Point(Loop)
U1: LM2575-12BU; TO-263-5_TabPin3
U2: LM2575-5.0BU; TO-263-5_TabPin3
U3: LM1117-3.3; SOT-223
U4: STM32F103RCT6; LQFP-64_10x10mm_P0.5mm
U5, U6, U7: IR2101; SOIC-8_W3.9mm
U8: CP2102; VFQFN-28-1EP_5x5mm_HandSolder
Y1: 8MHz; CRYSTAL_HC49_SMD

Connections:
+3.3V: BC1.1, BC2.1, BC3.1, BC4.1, BC5.1, C7.1, C9.1, C13.1, C39.1, D8.2, D33.2, D34.2, J2.1, J2.2, J3.1, L3.2, R6.1, R7.1, R36.2, TP2(+3.3V).1, U3.2, U4.1, U4.19, U4.32, U4.48, U4.64, U8.6, U8.7
+5V: C3.1, C6.1, C11.1, C29.1, C35.1, J4.1, J5.2, L2.2, R29.1, R30.2, R31.1, R32.1, RV1.1, TP4(+5V).1, U2.4, U3.3
+12V: C10.1, C12.1, C19.1, C20.1, C21.1, D13.2, D14.2, D15.2, D16.A, D17.A, D18.A, L1.2, TP3(+12V).1, U1.4, U5.1, U6.1, U7.1
+24V: BC6.1, BC7.1, BC8.1, BC9.1, C1.1, C2.1, C4.1, C5.1, C8.1, C30.1, C33.1, D25.1, D27.1, D29.1, D31.K, Q1.2, Q3.2, Q5.2, TH1.1, TP1(+24V).1, U1.1, U2.1
/sheet5FA8433B/A: J5.15, R30.1
/sheet5FA8433B/V0: J5.3, RV1.2
BOOT0: R6.2, SW2.1, U4.60
CURRENT: C28.1, R28.2, U4.26
D+: C36.1, J6.3, U8.4
D-: C37.1, J6.2, U8.5
DEBUG1: D9.2, TP5.1, U4.8
DEBUG2: D10.2, TP6.1, U4.9
DEBUG3: D11.2, TP7.1, U4.10
DEBUG4: D12.2, TP8.1, U4.11
GND: BC1.2, BC2.2, BC3.2, BC4.2, BC5.2, C2.2, C3.2, C5.2, C6.2, C7.2, C9.2, C11.2, C13.2, C14.2, C15.2, C16.2, C17.2, C18.2, C29.2, C31.2, C32.2, C34.2, C35.2, C36.2, C37.2, C38.2, C39.2, D5.A, D7.2, J2.3, J2.4, J2.5, J2.6, J2.8, J2.10, J2.12, J2.14, J2.16, J2.18, J2.20, J3.4, J4.2, J5.1, J5.16, J6.5, J6.6, R1.2, R2.2, R3.2, R4.2, R5.2, R8.2, R33.2, RV1.3, SW2.2, SW3.1, SW4.1, SW5.1, SW6.1, SW7.2, TP9(GND).1, TP10(GND).1, U2.3, U2.5, U3.1, U4.12, U4.18, U4.31, U4.47, U4.63, U8.3
GNDPWR: BC6.2, BC7.2, BC8.2, BC9.2, C1.2, C4.2, C8.2, C10.2, C12.2, C19.2, C20.2, C21.2, C28.2, C30.2, C33.2, D3.A, D4.A, D6.2, D31.A, J1.2, R8.1, R9.1, R10.1, R11.1, R12.1, R13.1, R14.1, R27.2, TP11(GNDPWR).1, TP12(GNDPWR).1, TP19(GNDPWR).1, TP20(GNDPWR).1, TP27.1, TP28.1, TP29.1, TP30.1, U1.3, U1.5, U4.27, U5.4, U6.4, U7.4
HA: C31.1, J4.6, R29.2, TP22(HA).1, U4.37
HB: C32.1, J4.7, R31.2, TP24(HB).1, U4.38
HC: C34.1, J4.8, R32.2, TP26(HC).1, U4.39
LCD_D0: J5.7, U4.28
LCD_D1: J5.8, U4.55
LCD_D2: J5.9, U4.56
LCD_D3: J5.10, U4.57
LCD_D4: J5.11, U4.58
LCD_D5: J5.12, U4.59
LCD_D6: J5.13, U4.61
LCD_D7: J5.14, U4.62
LCD_E: J5.6, U4.51
LCD_RS: J5.4, U4.53
LCD_RW: J5.5, U4.52
NRST: C14.1, J2.15, R7.2, SW7.1, U4.7
unnamed: C15.1, U4.5, Y1.1
unnamed: C16.1, U4.6, Y1.2
unnamed: C17.1, C18.1, L3.1, U4.13
unnamed: C22.1, C25.1, D13.1, D16.K, U5.8
unnamed: C22.2, C25.2, D25.2, D26.1, J4.3, Q1.3, Q2.2, R21.2, TP21(U).1, U5.6
unnamed: C23.1, C26.1, D14.1, D17.K, U6.8
unnamed: C23.2, C26.2, D27.2, D28.1, J4.4, Q3.3, Q4.2, R23.2, TP23(V).1, U6.6
unnamed: C24.1, C27.1, D15.1, D18.K, U7.8
unnamed: C24.2, C27.2, D29.2, D30.1, J4.5, Q5.3, Q6.2, R25.2, TP25(W).1, U7.6
unnamed: D1.A, D2.2, SW1.2
unnamed: D1.K, D2.1, D3.K, TH1.2
unnamed: D4.K, D6.1, L1.1, U1.2
unnamed: D5.K, D7.1, L2.1, U2.2
unnamed: D8.1, R1.1
unnamed: D9.1, R2.1
unnamed: D10.1, R3.1
unnamed: D11.1, R4.1
unnamed: D12.1, R5.1
unnamed: D19.A, Q1.1, R15.2, R21.1
unnamed: D19.K, R15.1, U5.7
unnamed: D20.A, Q2.1, R16.2, R22.1
unnamed: D20.K, R16.1, U5.5
unnamed: D21.A, Q3.1, R17.2, R23.1
unnamed: D21.K, R17.1, U6.7
unnamed: D22.A, Q4.1, R18.2, R24.1
unnamed: D22.K, R18.1, U6.5
unnamed: D23.A, Q5.1, R19.2, R25.1
unnamed: D23.K, R19.1, U7.7
unnamed: D24.A, Q6.1, R20.2, R26.1
unnamed: D24.K, R20.1, U7.5
unnamed: D26.2, D28.2, D30.2, Q2.3, Q4.3, Q6.3, R22.2, R24.2, R26.2, R27.1, R28.1
unnamed: D32.1, R33.1
unnamed: D33.1, R34.2
unnamed: D34.1, R35.2
unnamed: F1.1, SW1.1
unnamed: F1.2, J1.1
unnamed: R36.1, U8.9
RXD: J3.3, R35.1, U4.17, U8.25
SW1: SW3.2, U4.20
SW2: SW4.2, U4.21
SW3: SW5.2, U4.22
SW4: SW6.2, U4.23
SWCLK: J2.9, U4.49
SWDIO: J2.7, U4.46
TXD: J3.2, R34.1, U4.16, U8.26
UB: R12.2, TP16(UB).1, U4.41, U5.3
UT: R9.2, TP13(UT).1, U4.34, U5.2
VB: R13.2, TP17(VB).1, U4.42, U6.3
VBUS: C38.1, D32.2, J6.1, U8.8
VT: R10.2, TP14(VT).1, U4.35, U6.2
WB: R14.2, TP18(WB).1, U4.43, U7.3
WT: R11.2, TP15(WT).1, U4.36, U7.2
