Ganghyeok/BLDC_Motor_Controller_24V/Firmware/BLDC_Motor_Controller_24V/BLDC_Motor_Controller_24V/Src/it.c

/*
 * it.c
 *
 *  Created on: Dec 18, 2020
 *      Author: Ganghyeok Lim
 */

#include "main.h"


void TIM6_IRQHandler(void)
{
	TIM_IRQHandling(&TIM6Handle);
}


void EXTI9_5_IRQHandler(void)
{
	EXTI_IRQHandling(BLDC1Handle.Init.GPIO_Pins_Hall);
}


void DMA1_Channel2_IRQHandler(void)
{
	DMA_IRQ_Handling(UART3Handle.hdmatx);
}


void EXTI0_IRQHandler(void)
{
	EXTI_IRQHandling(GPIO_PIN_0);


//	EXTI->PR |= GPIO_PIN_0;		// Clear the pending event from EXTI line
//
//	if(Mode_key >= 3)
//	{
//		Mode_key = 0;
//	}
//	else
//	{
//		Mode_key++;
//	}
}


void EXTI1_IRQHandler(void)
{
	EXTI_IRQHandling(GPIO_PIN_1);
}


void EXTI2_IRQHandler(void)
{
	EXTI_IRQHandling(GPIO_PIN_2);
}


void EXTI3_IRQHandler(void)
{
	EXTI_IRQHandling(GPIO_PIN_3);

//	EXTI->PR |= GPIO_PIN_3;		// Clear the pending event from EXTI line
//
//	if(Start_key >= 1)
//	{
//		Start_key = 0;
//	}
//	else
//	{
//		Start_key++;
//	}
}


void EXTI4_IRQHandler(void)
{
	EXTI_IRQHandling(GPIO_PIN_4);
}
