Ganghyeok/BLDC_Motor_Controller_24V/(commit log)

2020-12-18 [Add] Schematic, PCB files, Firmware
    [BLDC_Motor_Controller_Ver1.0A.kicad_pcb, BLDC_Motor_Controller_Ver1.0A.sch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]
2020-12-18 [Test] UART_Transmit_IT
    -Test (PASS) UART_Transmit_IT
2020-12-19 [Test] TIM Base interrupt generation
    -Test (PASS) TIM Base interrupt generation
2020-12-19 [Test] TIM PWM generation for ch1~4
    - Test (PASS) TIM PWM generation for ch1~4 with arbitrary duty
2020-12-19 [Add & Test] Remapping of TIM3 port
    - Add AFIO Remapping Macro of TIM3
    - Test Remapping port of TIM3 and PWM generation test for ch1~4 with Remapped port(PC6/7/8/9)
2021-01-01 [Add] BLDC drive with Hall sensor
2021-01-03 [Add & Refactor & Fix] See the details
    - Add Start or Stop BLDC motor by using Button
    - Fix 'BLDC_BootstrapCap_Charge' function
    - Refactoring Refactor the entire code for Readability and Extensibility
    Introduce BLDC Handler that makes the manipulation of BLDC functions
    [bldc.c, bldc.h, common.c, common.h, it.c, main.h, msp.c]
2021-01-05 [Add] Function to Get Rotor Position(deg)
    - Add Function to Get Rotor Position(deg)
    UART2 to transmit data to PC
2021-01-05 [Add] Add function to Get Rotor Speed(rpm)
    - Add Add function to Get Rotor Speed(rpm)
    - Fix Change the period of TIM6 interrupt
    [bldc.c, bldc.h, user_func.c]
2021-01-07 [Add] Add UART2 Transmission with DMA(Hardcoded)
    - Add Transmit Motor speed value to PC by using UART2 DMA mode
2021-01-09 [Add] UART2 Transmission with DMA (Extensible)
    - Add Transmit Motor speed value(CW/CCW) to PC by using UART2 DMA mode (with DMA driver)
2021-01-10 [Add] PID Speed Control
    - Add PID Speed Control Code & Test figures with various Kp, Ki, Kd
2021-01-11 [Add] PID Position Control
    - Add PID Position Control Code
2021-01-12 [Fix] PID Position Control
    - Fix Change TIM_PSC, TIM_ARR value of TIM4 which generates PWM signal, in order to adjust the PWM duty cycle precisely.
    Remove the mimimum PWM duty cycle value '5', I think it is useless
    [bldc.c, msp.c, user_func.c]
2021-01-13 [Add] PID Position Control with Speed profile
    - Add PID Position Control with Trapezoidal & Isosceles triangle Speed profile.
    -> It works well, but it still needs precise adjustment (ex. "Vibration depends on Acceleration, Kp, Ki" / "Trajectory generation function", etc.)
    -> it also needs some Refactoring
    [bldc.c, user_func.c]
2021-01-18 [Fix] TFT LCD pin change
    - Fix TFT LCD pin change
    TFT_nRST : PA0 -> PA8
    TFT_nCS : PA1 -> PA9
    TFT_RS : PA2 -> PA10
    TFT_nWR : PA3 -> PA11
    [msp.c]
2021-01-19 [Fix] Pin change for Hall sensor & UART
    - Fix HA : PC6 -> PA5
    HB : PC7 -> PA6
    HC : PC8 -> PA7
    UART2_TX(PA2) -> UART3_TX(PB10)
    UART2_RX(PA3) -> UART3_RX(PB11)
    SW(Emergency Stop) : PA7 -> PA4
    [bldc.c, it.c, main.h, msp.c, tft.c, user_func.c]
2021-01-19 [Refactor & Test] PID position tracking with TFT
    - Test PID position tracking with displaying touch screen input
2021-01-20 [Refactor & Test] PID speed with TFT
    - Test PID speed with displaying touch screen input
2021-01-23 [Add] Graph of Speed / Position value
    [BLDC_Motor_Controller_Ver2.0A.kicad_pcb, BLDC_Motor_Controller_Ver2.0A.sch]
2021-02-27 [Add] PCB design & Firmware funcitons
    [BLDC_Motor_Controller_Ver1.0A_TEST.kicad_pcb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]
